vineeetbem/pedro/Production/BOM_Board1_PCB1_2026-08-27.xlsx

No. | Quantity | Comment | Designator | Footprint | Value | Manufacturer Part | Manufacturer | Supplier Part | Supplier
1 | 23 | 100nF | C22,C23,C24,C25,C26,C27,C83,C114,C117,C120,C121,C122,C123,C136,C138,C146,C147,C153,C154,C155,C159,C165,C171 | C0402 | 100nF | CC0402KRX7R7BB104 | YAGEO(国巨) | C60474 | LCSC
2 | 2 | 10nF | C32,C135 | C0402 | 10nF | CC0402KRX7R9BB103 | YAGEO(国巨) | C60133 | LCSC
3 | 1 | 33nF | C82 | C0402 | 33nF | CC0402KRX7R9BB333 | YAGEO(国巨) | C106862 | LCSC
4 | 2 | 12pF | C84,C85 | C0402 | 12pF | 0402CG120J500NT | FH(风华) | C1547 | LCSC
5 | 6 | 2.2uF | C89,C90,C115,C118,C119,C137 | C0402 | 2.2uF | CL05A225MQ5NSNC | SAMSUNG(三星) | C12530 | LCSC
6 | 1 | 4.7uF | C102 | C0402 | 4.7uF | CL05A475MP5NRNC | SAMSUNG(三星) | C23733 | LCSC
7 | 2 | 10uF | C133,C134 | C0603 | 10uF | CL10A106KP8NNNC | SAMSUNG(三星) | C19702 | LCSC
8 | 4 | 22uF | C150,C152,C156,C158 | C0603 | 22uF | CL10A226MO7JZNC | SAMSUNG(三星) | C2762594 | LCSC
9 | 2 | 10uF | C151,C157 | C0603 | 10uF | CL10A106MA8NRNC | SAMSUNG(三星) | C96446 | LCSC
10 | 4 | 4.7uF | C160,C161,C166,C167 | C1206 | 4.7uF | CM316X7S475K100AT | Kyocera AVX | C2900750 | LCSC
11 | 1 | 330pF | C162 | C0402 | 330pF | 0402B331K500NT | FH(风华) | C1535 | LCSC
12 | 2 | 33uF | C163,C164 | C1206 | 33uF | C3216X5R1E336MT000E | TDK | C342307 | LCSC
13 | 1 | 470pF | C168 | C0402 | 470pF | CC0402KRX7R9BB471 | YAGEO(国巨) | C106207 | LCSC
14 | 2 | 22uF | C169,C170 | C1206 | 22uF | CGA1206X5R226M350NT | HRE(芯声) | C6119969 | LCSC
15 | 1 | 5033981892 | CARD4 | TF-SMD_503398-1892 |  | 5033981892 | MOLEX | C428492 | LCSC
16 | 1 | SMAJ40A | D2 | SMA_L4.4-W2.6-LS5.0-RD |  | SMAJ40A | FMS(美丽微) | C143131 | LCSC
17 | 2 | DSK34 | D4,D5 | SOD-123_L2.8-W1.8-LS3.7-RD |  | DSK34 | FUXINSEMI(富芯森美) | C908230 | LCSC
18 | 2 | SS310 | D6,D7 | SMA_L4.3-W2.6-LS5.2-RD |  | SS310 | MDD | C15874 | LCSC
19 | 1 | BLM15PD121SN1D | L3 | L0402 |  | BLM15PD121SN1D | muRata(村田) | C76891 | LCSC
20 | 2 | 10uH | L8,L9 | IND-SMD_L4.4-W4.2 | 10uH | FXL0420-100-M | cjiang(长江微电) | C177242 | LCSC
21 | 3 | NCD0402R1 | LED6,LED7,LED8 | LED0402-RD |  | NCD0402R1 | 国星光电 | C130719 | LCSC
22 | 1 | SS8050W | Q4 | SOT-323-3_L2.1-W1.3-P1.30-LS2.3-BR |  | SS8050W | CBI(创基) | C2836073 | LCSC
23 | 2 | 120Ω | R56,R172 | R0402 | 120Ω | 0402WGF1200TCE | UNI-ROYAL(厚声) | C25079 | LCSC
24 | 8 | 4.7kΩ | R76,R88,R184,R185,R190,R191,R223,R224 | r0402 | 4.7kΩ | 0402WGF4701TCE | UNI-ROYAL(厚声) | C25900 | LCSC
25 | 2 | 5.1kΩ | R99,R100 | R0402 | 5.1kΩ | 0402WGF5101TCE | UNI-ROYAL(厚声) | C25905 | LCSC
26 | 2 | 22Ω | R101,R102 | R0402 | 22Ω | 0402WGF220JTCE | UNI-ROYAL(厚声) | C25092 | LCSC
27 | 16 | 10kΩ | R108,R109,R110,R111,R118,R119,R130,R131,R143,R173,R196,R198,R199,R201,R202,R227 | R0402 | 10kΩ | RC0402FR-0710KL | YAGEO(国巨) | C60490 | LCSC
28 | 3 | 1kΩ | R126,R171,R228 | R0402 | 1kΩ | 0402WGF1001TCE | UNI-ROYAL(厚声) | C11702 | LCSC
29 | 2 | 75Ω | R128,R129 | R0402 | 75Ω | 0402WGF750JTCE | UNI-ROYAL(厚声) | C25133 | LCSC
30 | 28 | 100Ω | R133,R134,R135,R136,R137,R138,R139,R140,R174,R175,R176,R177,R178,R179,R180,R181,R182,R183,R186,R187,R188,R189,R192,R193,R194,R195,R225,R226 | R0402 | 100Ω | 0402WGF1000TCE | UNI-ROYAL(厚声) | C25076 | LCSC
31 | 1 | 20kΩ | R170 | R0402 | 20kΩ | 0402WGF2002TCE | UNI-ROYAL(厚声) | C25765 | LCSC
32 | 2 | 2.2kΩ | R197,R200 | R0402 | 2.2kΩ | 0402WGF2201TCE | UNI-ROYAL(厚声) | C25879 | LCSC
33 | 2 | 17.4kΩ | R203,R210 | R0402 | 17.4kΩ | 0402WGF1742TCE | UNI-ROYAL(厚声) | C26957 | LCSC
34 | 2 | 100kΩ | R204,R211 | R0402 | 100kΩ | RC0402FR-07100KL | YAGEO(国巨) | C60491 | LCSC
35 | 1 | 47.5kΩ | R206 | R0402 | 47.5kΩ | 0402WGF4752TCE | UNI-ROYAL(厚声) | C25896 | LCSC
36 | 2 | 40.2kΩ | R207,R214 | R0402 | 40.2kΩ | 0402WGF4022TCE | UNI-ROYAL(厚声) | C25893 | LCSC
37 | 2 | 20Ω | R209,R216 | R0402 | 20Ω | 0402WGF200JTCE | UNI-ROYAL(厚声) | C25089 | LCSC
38 | 1 | 16kΩ | R213 | R0402 | 16kΩ | 0402WGF1602TCE | UNI-ROYAL(厚声) | C25759 | LCSC
39 | 1 | 560kΩ | R219 | R0402 | 560kΩ | RC0402FR-07560KL | YAGEO(国巨) | C137958 | LCSC
40 | 1 | 220kΩ | R220 | R0402 | 220kΩ | 0402WGF2203TCE | UNI-ROYAL(厚声) | C25767 | LCSC
41 | 2 | 200kΩ | R221,R222 | R0402 | 200kΩ | 0402WGF2003TCE | UNI-ROYAL(厚声) | C25764 | LCSC
42 | 2 | 220Ω | R229,R230 | R0402 | 220Ω | 0402WGF2200TCE | UNI-ROYAL(厚声) | C25091 | LCSC
43 | 1 | TS-1089S-02526 | SW3 | SW-SMD_4P-L4.2-W3.3-P2.15-LS5.1 |  | TS-1089S-02526 | XUNPU(讯普) | C455282 | LCSC
44 | 1 | AT7456E | U6 | TSSOP-28_L9.7-W4.4-P0.65-LS6.4-BL-EP-2 |  | AT7456E | 杭州中科微 | C82351 | LCSC
45 | 2 | ICM-42688-P | U30,U58 | LGA-14_L3.0-W2.5-P0.50-TL |  | ICM-42688-P | TDK InvenSense(应美盛) | C1850418 | LCSC
46 | 1 | IST8310 | U37 | LGA-16_L3.0-W3.0-P0.5-BL |  | IST8310 |  | C9900047266 | LCSC
47 | 2 | TJA1051TK/3/1J | U38,U67 | HVSON-8_L3.0-W3.0-P0.65-BL-EP |  | TJA1051TK/3/1J | NXP(恩智浦) | C2875699 | LCSC
48 | 1 | MS560702BA03-50 | U59 | SENSOR-SMD_MS560702BA03-50 |  | MS560702BA03-50 | TE Connectivity(泰科电子) | C97627 | LCSC
49 | 1 | ZX-SH1.0-6PWT | U60 | CONN-SMD_6P-P1.00_MEGASTAR_ZX-SH1.0-6PWT |  | ZX-SH1.0-6PWT | Megastar(兆星) | C7430448 | LCSC
50 | 1 | STM32H743VIH6 | U65 | BGA-100_L8.0-W8.0-P0.80-R10-C10-BL |  | STM32H743VIH6 | ST(意法半导体) | C964146 | LCSC
51 | 1 | ZX-SH1.0-8PWT | U70 | CONN-SMD_8P-P1.00_MEGASTAR_ZX-SH1.0-8PWT |  | ZX-SH1.0-8PWT | Megastar(兆星) | C7430450 | LCSC
52 | 1 | BX-GH1.25-4PWT | U71 | CONN-SMD_4P-P1.25_BX-GH1.25-4PWT |  | BX-GH1.25-4PWT | Bossie(博锡) | C18077720 | LCSC
53 | 1 | LP5912-3.3DRVT | U98 | wson-6_l2.0-w2.0-p0.65-tl-ep |  | LP5912-3.3DRVT | TI(德州仪器) | C134121 | LCSC
54 | 87 | 焊盘原件 | U106,U114,U115,U116,U117,U118,U121,U122,U123,U124,U127,U128,U129,U130,U131,U132,U133,U134,U135,U136,U137,U138,U139,U140,U141,U142,U143,U144,U145,U146,U147,U148,U149,U150,U151,U152,U153,U154,U155,U156,U157,U158,U159,U160,U161,U162,U163,U164,U165,U166,U167,U168,U169,U170,U171,U172,U173,U174,U175,U176,U177,U178,U179,U180,U181,U182,U183,U184,U185,U186,U187,U188,U189,U190,U191,U192,U193,U194,U195,U196,U197,U198,U199,U200,U201,U202,U203 | 焊盘1.3
55 | 4 | ZX-GH1.25-WT6 | U119,U120,U125,U126 | CONN-SMD_6P-P1.25_ZX-GH1.25-WT6 |  | ZX-GH1.25-WT6 | Megastar(兆星) | C7429519 | LCSC
56 | 1 | LP5912-3.3DRVT | U204 | WSON-6_L2.0-W2.0-P0.65-TL-EP |  | LP5912-3.3DRVT | TI(德州仪器) | C134121 | LCSC
57 | 2 | MP4560DQ | U205,U206 | MP4560DQ
58 | 1 | TYPEC-304-BCP16 | USB1 | USB-C-SMD_TYPEC-304-BCP16_2 |  | TYPEC-304-BCP16 | XUNPU(讯普) | C2909610 | LCSC
59 | 1 | 8M Hz | X2 | OSC-SMD_3P-L3.2-W1.3-P1.20-L |  | CSTNE8M00GH5C000R0 | muRata(村田) | C341525 | LCSC
60 | 1 | 27MHz | X3 | CRYSTAL-SMD_4P-L2.0-W1.6-BL-A | 27MHz | TAXM24M4ZDBCCT2T | TAE(雅晶鑫) | C5210654 | LCSC
