vineeetbem/pedro/(list of files, drawings)

Other design files:
PCB/ProPrj_PEDRO.epro
